PurpleMyst/carroponte/SchemaKiCAD/SchemaKiCAD.kicad_sch

## KiCad design SchemaKiCAD/SchemaKiCAD.kicad_sch (2023-07-24, an earlier design)

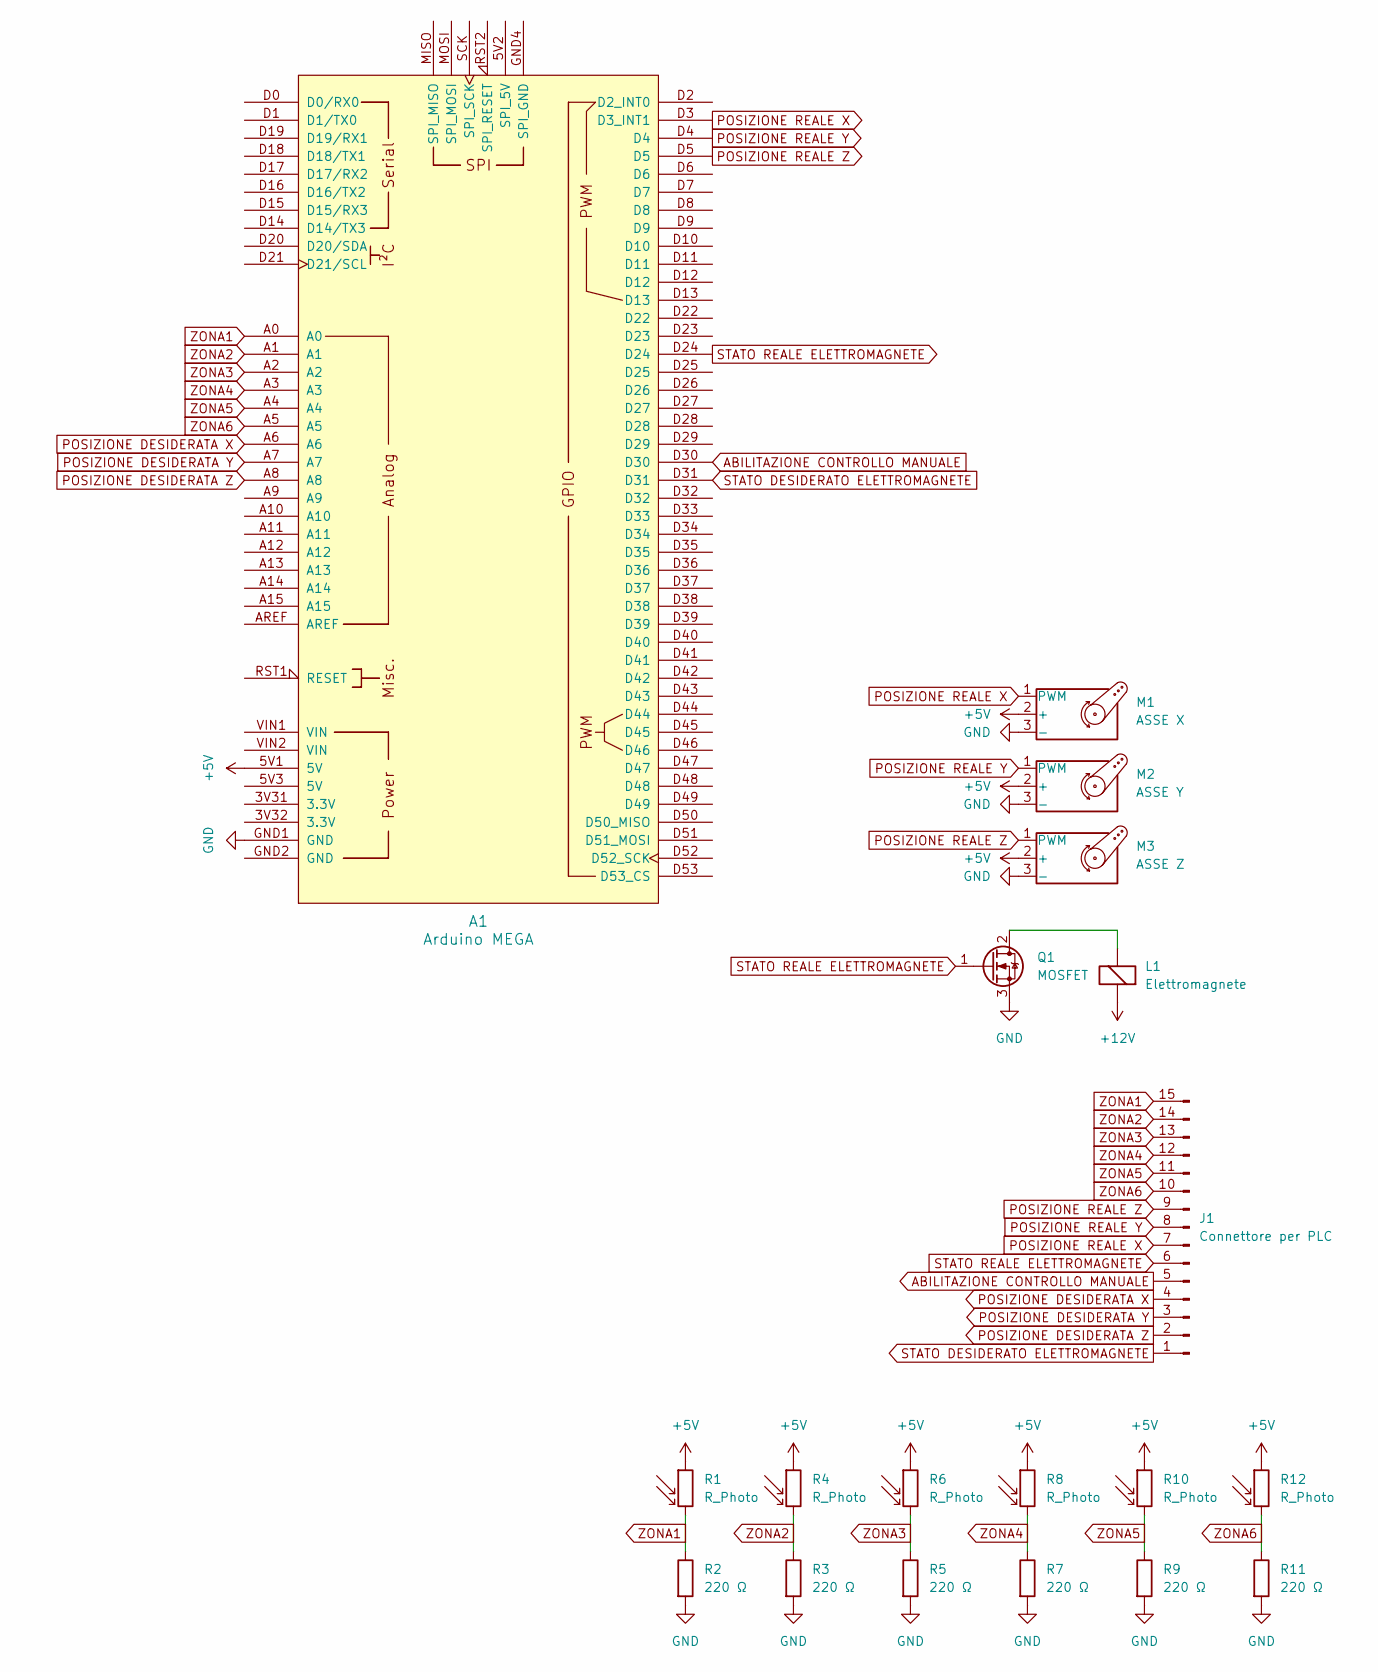
[picture p2: schematic SchemaKiCAD.kicad_sch]

Parts:
A1: Arduino MEGA; Clone_Mega2560_Pro_Socket
J1: Connettore per PLC
L1: Elettromagnete
M1: ASSE X
M2: ASSE Y
M3: ASSE Z
Q1: MOSFET
R1, R4, R6, R8, R10, R12: R_Photo
R2, R3, R5, R7, R9, R11: 220 Ω

Connections:
+5V: A1.5V1 (5V), M1.2 (+), M2.2 (+), M3.2 (+), R1.1, R4.1, R6.1, R8.1, R10.1, R12.1
+12V: L1.1 (-)
ABILITAZIONE CONTROLLO MANUALE: A1.D30, J1.5
GND: A1.GND1 (GND), M1.3 (-), M2.3 (-), M3.3 (-), Q1.3 (S), R2.2, R3.2, R5.2, R7.2, R9.2, R11.2
unnamed: L1.2 (+), Q1.2 (D)
POSIZIONE DESIDERATA X: A1.A6, J1.4
POSIZIONE DESIDERATA Y: A1.A7, J1.3
POSIZIONE DESIDERATA Z: A1.A8, J1.2
POSIZIONE REALE X: A1.D3 (D3_INT1), J1.7, M1.1 (PWM)
POSIZIONE REALE Y: A1.D4, J1.8, M2.1 (PWM)
POSIZIONE REALE Z: A1.D5, J1.9, M3.1 (PWM)
STATO DESIDERATO ELETTROMAGNETE: A1.D31, J1.1
STATO REALE ELETTROMAGNETE: A1.D24, J1.6, Q1.1 (G)
ZONA1: A1.A0, J1.15, R1.2, R2.1
ZONA2: A1.A1, J1.14, R3.1, R4.2
ZONA3: A1.A2, J1.13, R5.1, R6.2
ZONA4: A1.A3, J1.12, R7.1, R8.2
ZONA5: A1.A4, J1.11, R9.1, R10.2
ZONA6: A1.A5, J1.10, R11.1, R12.2
