PurpleMyst/carroponte/(commit log)

2023-06-27 feat: aggiunto esperimento per il motore asse x
2023-06-28 feat: aggiunto esperimento per asse x con sola coppia di finecorsa
2023-07-04 feat: aggiunta terza prova motore asse x
2023-07-04 Update TerzaProvaMotoreAsseX.ino
    Aggiunto ";" in void printTime()
2023-07-04 fix: fermare il motore DC quando si raggiunge la posizione desiderata
    [ProgrammaPrincipale.ino]
2023-07-07 fix: errori nel codice rilevati da verify + passaggio a libraria diversa per modbus vista incompatibilità della precedente con il Galileo
    [ProgrammaPrincipale.ino]
2023-07-11 feat: tentativo di utilizzo del fast stop nella terza prova del motore
2023-07-11 Update TerzaProvaMotoreAsseX.ino
    Riduzione Speed a 230, inserita currentPosition = 0.0 nel setum
2023-07-15 feat: aggiunto test per asse x ultrasonico
2023-07-17 feat: rimozione di tutto ciò che è superfluo
2023-07-17 feat: seconda relazione di fattibilità dovuta a cambiamenti sostanziali del progetto
2023-07-18 feat: riscrittura programma conforme a seconda relazione di fattibilità
2023-07-18 fix: risolti errore di compilazione
    [ProgrammaPrincipale.ino, Zone.cpp, Zone.hpp]
2023-07-18 fix: aggiunti & mancanti dove è necessario per la manipolazione delle reference
    [ProgrammaPrincipale.ino, ServoAxis.hpp, Zone.cpp]
2023-07-22 fix: aggiornamenti dopo incontro
    [ProgrammaPrincipale.ino, ServoAxis.cpp, ServoAxis.hpp, TaraturaAssi.ino]
2023-07-23 feat: aggiunto schema kicad
    [SchemaKiCAD.kicad_pcb, SchemaKiCAD.kicad_sch]
2023-07-23 feat: sperabilmente tuttapposto!
    [SchemaKiCAD.kicad_sch]
2023-07-23 fix: cambio pin nel diagramma elettrico
    [SchemaKiCAD.kicad_sch]
2023-07-23 fix: sistemazioni dopo incontro
    [ProgrammaPrincipale.ino, Zone.cpp, Zone.hpp]
2023-07-24 fix: lettura fotoresistori più stabili
    [ProgrammaPrincipale.ino, Zone.cpp, Zone.hpp]
2023-07-24 fix: ulteriori aggiustamenti
    [SchemaKiCAD.kicad_sch]
2023-07-24 fix: era scomparso il codice lmao
2023-07-26 feat: aggiunzione argomenti di teoira
2023-07-27 improvement: sistemazioni di impaginazione ed aggiunta di piccolo paragrafo sulla programmazione SCADA
